minwoo02/PPG-Analog-Front-End/images/vref_buffer.png

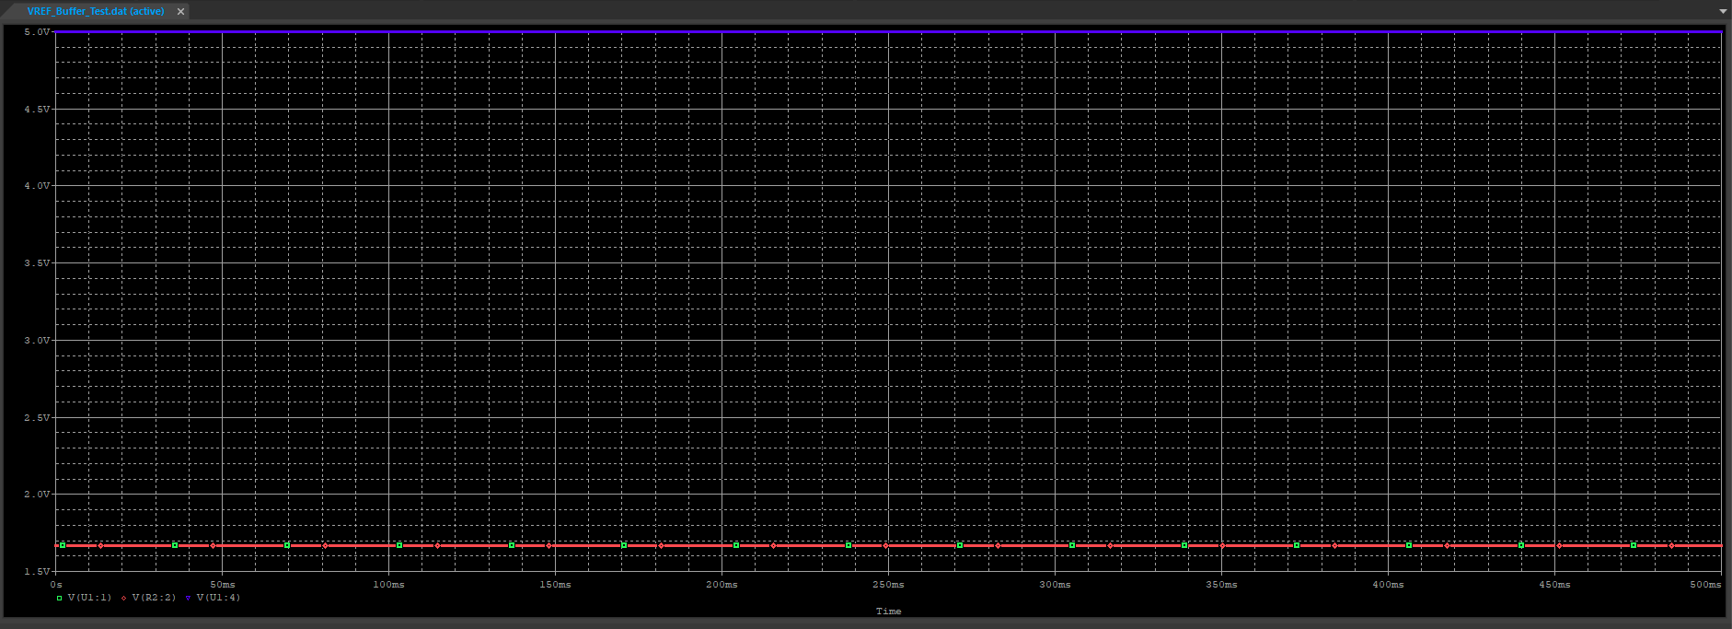
images/vref_buffer.png
