minwoo02/PPG-Analog-Front-End/PPG_ANALOG_FRONT_END.png

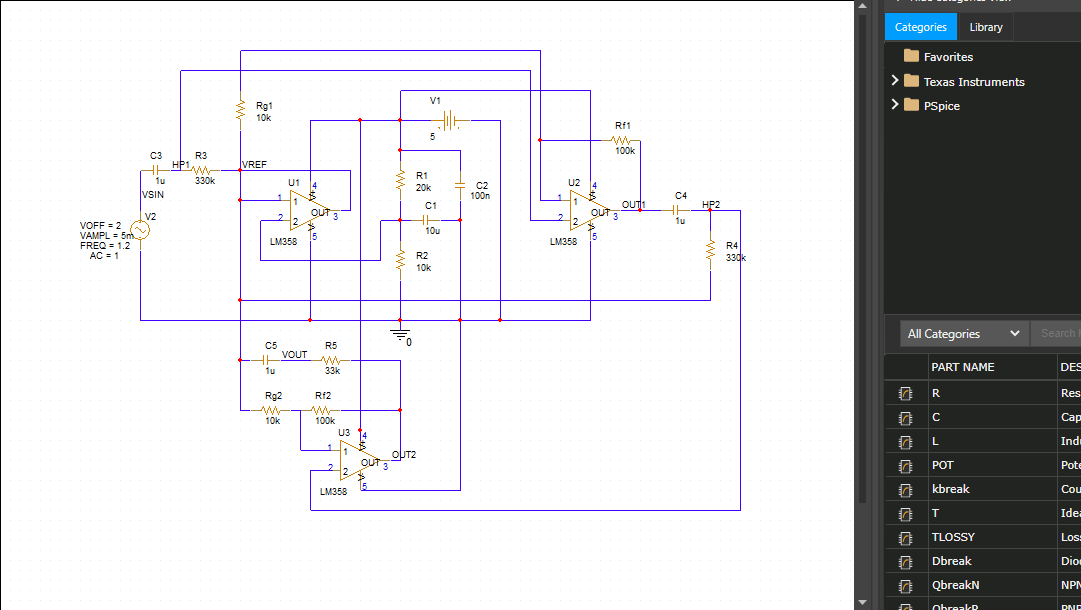
PPG_ANALOG_FRONT_END.png
