minwoo02/PPG-Analog-Front-End/(list of files, drawings)

Other design files:
PPG_ANALOG_FRONT_END.DSN
PPG_Analog_Front_End.opj
